edtamarin/Canon-Intervalometer/Hardware/remote_shutter/BOM.xlsx

Part | Description | Price | Qty | Total | Link
ESP32 Pico Mini 02 | MCU | €4.73 | 1 | €4.73 | ESP32-PICO-MINI-02-N8R2 Espressif Systems | C2980306 - LCSC Electronics (https://www.lcsc.com/product-detail/WiFi-Modules_Espressif-Systems-ESP32-PICO-MINI-02-N8R2_C2980306.html)
4-1437565-2 | Pushbuttons | €0.20 | 5 | €1.00 | 4-1437565-2 TE Connectivity | C86487 - LCSC Electronics (https://www.lcsc.com/product-detail/Tactile-Switches_TE-Connectivity-4-1437565-2_C86487.html)
C18594 | 3.5mm jack | €0.55 | 1 | €0.55 | C18594 BOOMELE(Boom Precision Elec) | C18594 - LCSC Electronics (https://www.lcsc.com/product-detail/Audio-Connectors_BOOMELE-Boom-Precision-Elec-C18594_C18594.html)
SIQ-02FVS3 | Rotary encoder | €2.01 | 1 | €2.01 | SIQ-02FVS3 Mitsumi Electric | C2925423 - LCSC Electronics (https://www.lcsc.com/product-detail/Rotary-Encoders_Mitsumi-Electric-SIQ-02FVS3_C2925423.html)
 | OLED Display | €23.50 | 1 | €23.50 | Monochroom 0.96" 128x64 OLED grafisch display (kiwi-electronics.com) (https://www.kiwi-electronics.com/nl/monochroom-0-96quot-128x64-oled-grafisch-display-754?search=oled)
DMN2056U-7 | N-MOSFET | €0.62 | 2 | €1.24 | DMN2056U-7 Diodes Incorporated | C332302 - LCSC Electronics (https://www.lcsc.com/product-detail/MOSFETs_Diodes-Incorporated-DMN2056U-7_C332302.html)
SBC847BDW1T1G | BJT | €0.62 | 1 | €0.62 | SBC847BDW1T1G onsemi | C232475 - LCSC Electronics (https://www.lcsc.com/product-detail/Bipolar-Transistors-BJT_onsemi-SBC847BDW1T1G_C232475.html)
U262-161N-4BVC11 | USB-C connector | €0.39 | 1 | €0.39 | U262-161N-4BVC11 XKB Connectivity | C319148 - LCSC Electronics (https://www.lcsc.com/product-detail/USB-Connectors_XKB-Connectivity-U262-161N-4BVC11_C319148.html)
AZ1117H-3.3TRE1 | LDO | €0.12 | 1 | €0.12 | AZ1117H-3.3TRE1 Diodes Incorporated | C92517 - LCSC Electronics (https://www.lcsc.com/product-detail/Linear-Voltage-Regulators-LDO_Diodes-Incorporated-AZ1117H-3-3TRE1_C92517.html)
NX3215SA-32.768K-STD-MUA-14 | Crystal | €0.37 | 1 | €0.37 | NX3215SA-32.768K-STD-MUA-14 NDK | C156244 - LCSC Electronics (https://www.lcsc.com/product-detail/Crystals_NDK-NX3215SA-32-768K-STD-MUA-14_C156244.html)
TC212B106K020Y | Tantalum capacitor | €0.24 | 1 | €0.24 | TC212B106K020Y Sunlord | C177761 - LCSC Electronics (https://www.lcsc.com/product-detail/Tantalum-Capacitors_Sunlord-TC212B106K020Y_C177761.html)
TAJB226K010RNJ | Tantalum capacitor | €0.07 | 1 | €0.07 | TAJB226K010RNJ Kyocera AVX | C7198 - LCSC Electronics (https://www.lcsc.com/product-detail/Tantalum-Capacitors_Kyocera-AVX-TAJB226K010RNJ_C7198.html)
MK-12D18-G020 | Slide switch | €0.63 | 1 | €0.63 | MK-12D18-G020 G-Switch | C3019727 - LCSC Electronics (https://www.lcsc.com/product-detail/Slide-Switches_G-Switch-MK-12D18-G020_C3019727.html)
 | USB-UART converter |  |  | €0.00 | 1317 POLOLU - Module: adapter | USB-UART; CP2102N; USB micro; 1.5x2.4mm; POLOLU-1317 | TME - Elektronische Componenten (https://www.tme.eu/nl/details/pololu-1317/converters/pololu/1317/)
TP4056 | Charge control circuit | €0.58 | 1 | €0.58 | TP4056 TPOWER | C382139 - LCSC Electronics (https://www.lcsc.com/product-detail/Battery-Management-ICs_TPOWER-TP4056_C382139.html)
