edtamarin/Canon-Intervalometer/Hardware/remote_shutter/remote_shutter.kicad_pcb

## KiCad design Hardware/remote_shutter/remote_shutter.kicad_pcb (2023-05-07)

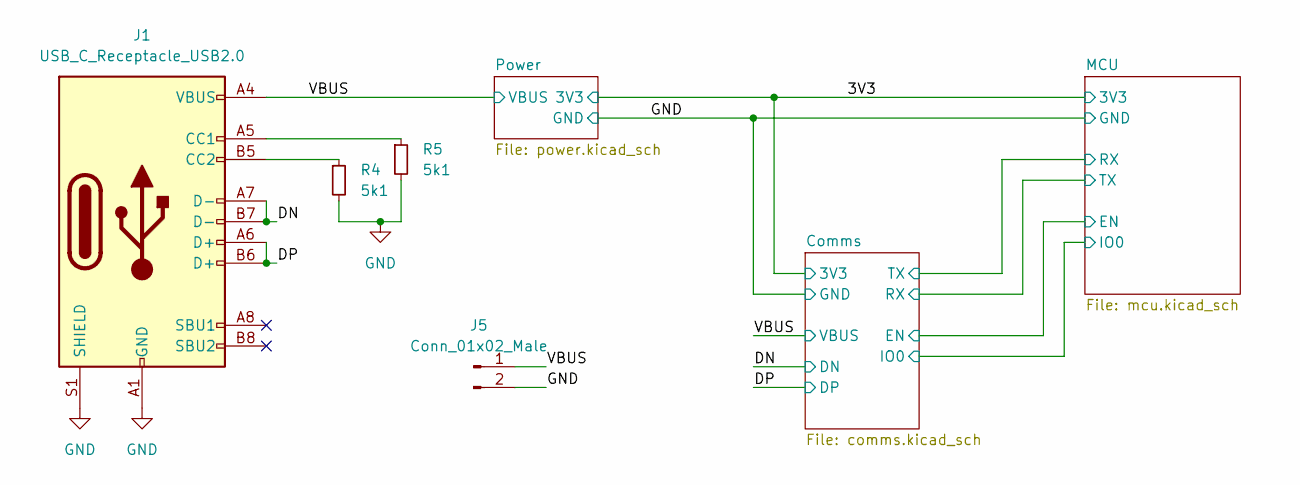
[picture p1: schematic remote_shutter.kicad_sch]

Parts:
J1: USB_C_Receptacle_USB2.0; USB_C_Receptacle_XKB_U262-16XN-4BVC11
J5: Conn_01x02_Male; PinHeader_1x02_P2.54mm_Vertical
R4, R5: 5k1; R_0603_1608Metric_Pad0.98x0.95mm_HandSolder

Connections:
/DN: J1.A7 (D-), J1.B7 (D-); also elsewhere on the board
/DP: J1.A6 (D+), J1.B6 (D+); also elsewhere on the board
/VBUS: J1.A4 (VBUS), J1.A9 (VBUS), J1.B4 (VBUS), J1.B9 (VBUS), J5.1; also elsewhere on the board
GND: J1.A1 (GND), J1.A12 (GND), J1.B1 (GND), J1.B12 (GND), J1.S1 (SHIELD), J5.2, R4.2, R5.2; also elsewhere on the board
unnamed: J1.A5 (CC1), R5.1
unnamed: J1.B5 (CC2), R4.1

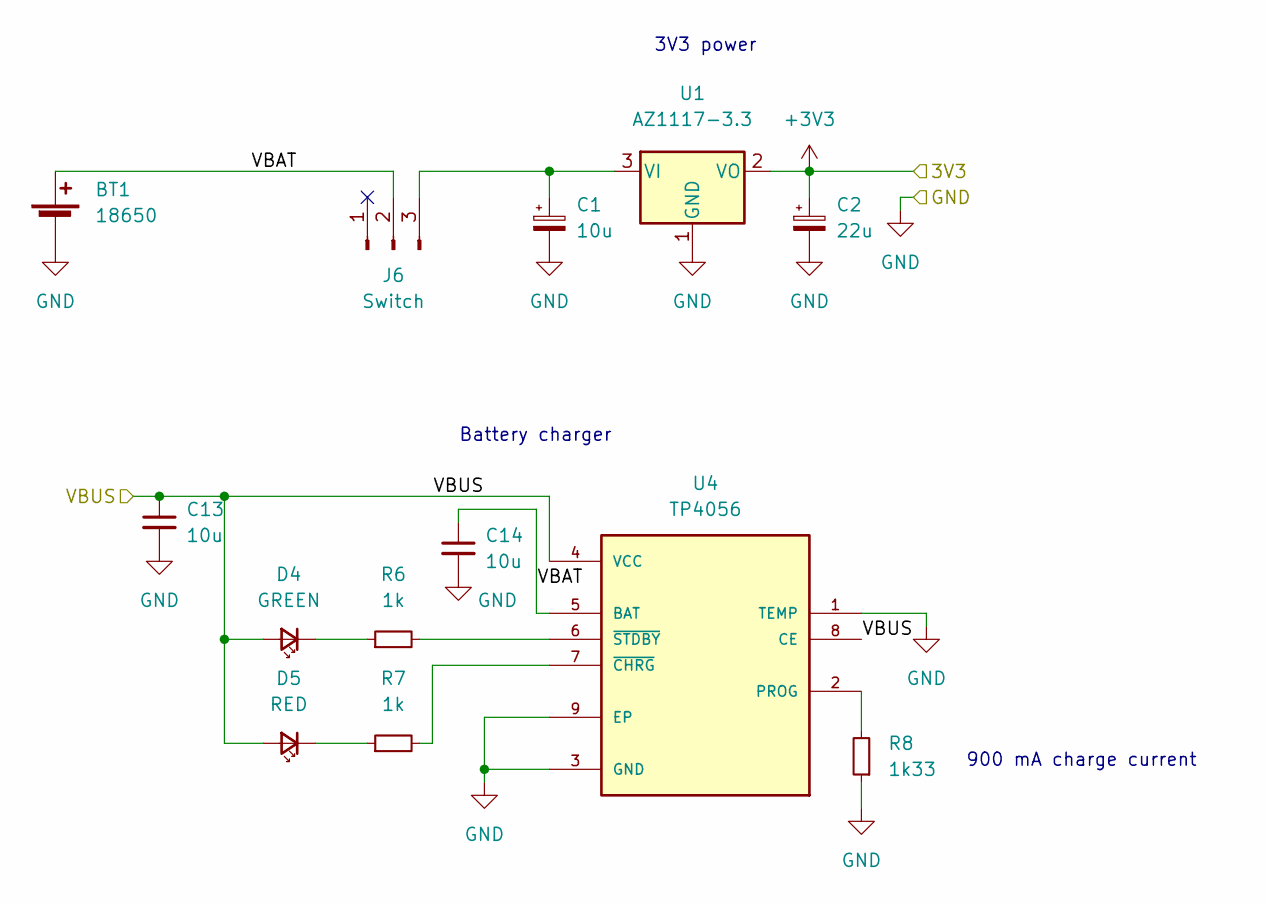
[picture p2: schematic power.kicad_sch]

Parts:
BT1: 18650; PinHeader_1x02_P2.54mm_Vertical
C1: 10u; CP_EIA-3528-21_Kemet-B_Pad1.50x2.35mm_HandSolder
C2: 22u; CP_EIA-3528-21_Kemet-B_Pad1.50x2.35mm_HandSolder
C13, C14: 10u; C_0805_2012Metric_Pad1.18x1.45mm_HandSolder
D4: GREEN; LED_0603_1608Metric_Pad1.05x0.95mm_HandSolder
D5: RED; LED_0603_1608Metric_Pad1.05x0.95mm_HandSolder
J6: Switch; PinHeader_1x03_P2.54mm_Vertical
R6, R7: 1k; R_0603_1608Metric_Pad0.98x0.95mm_HandSolder
R8: 1k33; R_0603_1608Metric_Pad0.98x0.95mm_HandSolder
U1: AZ1117-3.3; SOT-223-3_TabPin2
U4: TP4056; SOP127P600X175-9N

Connections:
+3V3: C2.1, U1.2 (VO); also elsewhere on the board
/Power/VBAT: BT1.1 (+), C14.1, J6.2, U4.5 (BAT)
/VBUS: C13.1, D4.2 (A), D5.2 (A), U4.4 (VCC), U4.8 (CE); also elsewhere on the board
GND: BT1.2 (-), C1.2, C2.2, C13.2, C14.2, R8.1, U1.1 (GND), U4.1 (TEMP), U4.3 (GND), U4.9 (EP); also elsewhere on the board
unnamed: C1.1, J6.3, U1.3 (VI)
unnamed: D4.1 (K), R6.1
unnamed: D5.1 (K), R7.1
unnamed: R6.2, U4.6 (~STDBY)
unnamed: R7.2, U4.7 (~CHRG)
unnamed: R8.2, U4.2 (PROG)

Notes on the sheet:
3V3 power
900 mA charge current
Battery charger

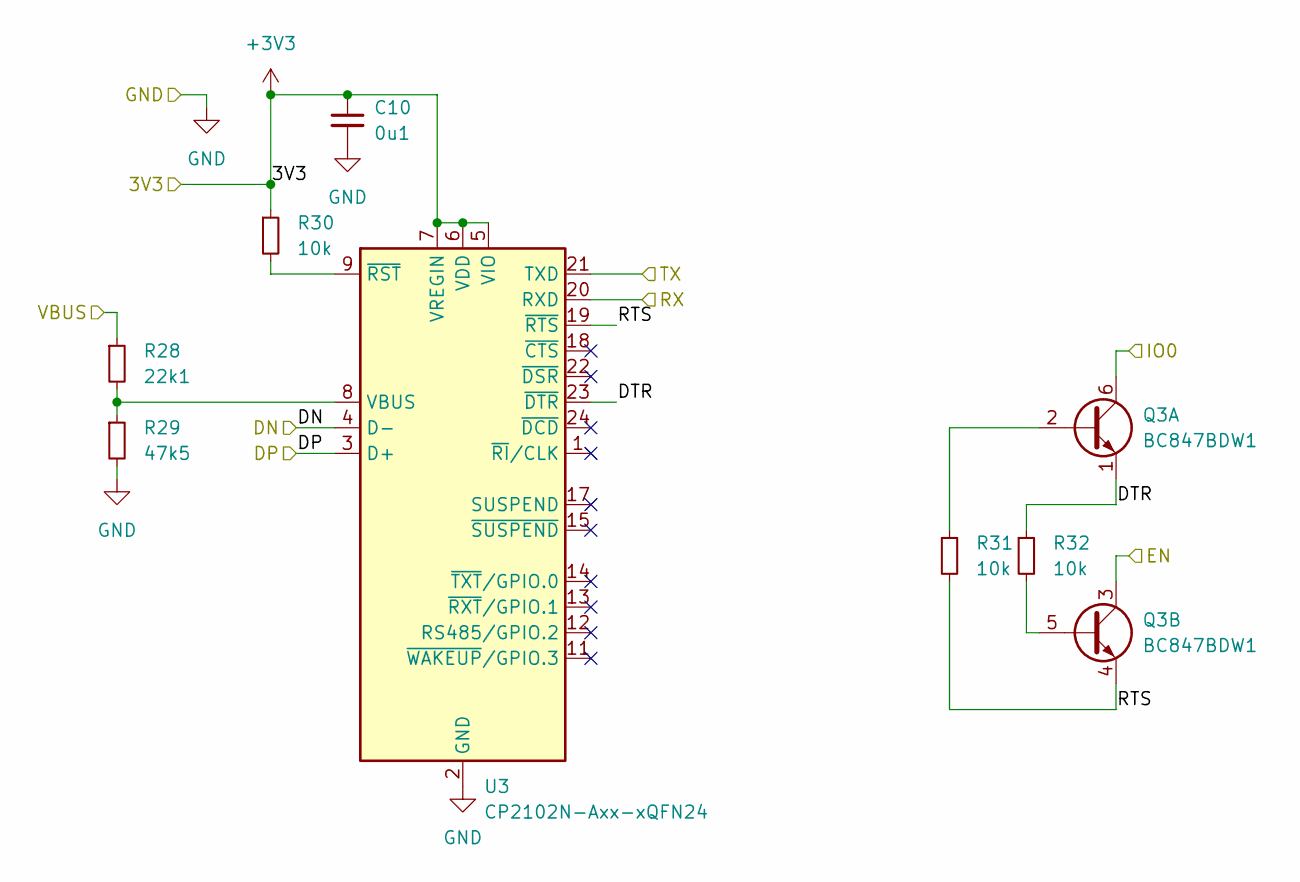
[picture p3: schematic comms.kicad_sch]

Parts:
C10: 0u1; C_0603_1608Metric_Pad1.08x0.95mm_HandSolder
Q3: BC847BDW1; SOT-363_SC-70-6
R28: 22k1; R_0603_1608Metric_Pad0.98x0.95mm_HandSolder
R29: 47k5; R_0603_1608Metric_Pad0.98x0.95mm_HandSolder
R30, R31, R32: 10k; R_0603_1608Metric_Pad0.98x0.95mm_HandSolder
U3: CP2102N-Axx-xQFN24; QFN-24-1EP_4x4mm_P0.5mm_EP2.6x2.6mm

Connections:
+3V3: C10.1, R30.1, U3.5 (VIO), U3.6 (VDD), U3.7 (VREGIN); also elsewhere on the board
/Comms/DTR: Q3.1 (E1), R32.1, U3.23 (~DTR)
/Comms/RTS: Q3.4 (E2), R31.2, U3.19 (~RTS)
/DN: U3.4 (D-); also elsewhere on the board
/DP: U3.3 (D+); also elsewhere on the board
/MCU/EN: Q3.3 (C2); also elsewhere on the board
/MCU/IO0: Q3.6 (C1); also elsewhere on the board
/MCU/RX: U3.21 (TXD); also elsewhere on the board
/MCU/TX: U3.20 (RXD); also elsewhere on the board
/VBUS: R28.1; also elsewhere on the board
GND: C10.2, R29.2, U3.2 (GND), U3.25 (GND); also elsewhere on the board
unnamed: Q3.2 (B1), R31.1
unnamed: Q3.5 (B2), R32.2
unnamed: R28.2, R29.1, U3.8 (VBUS)
unnamed: R30.2, U3.9 (~RST)

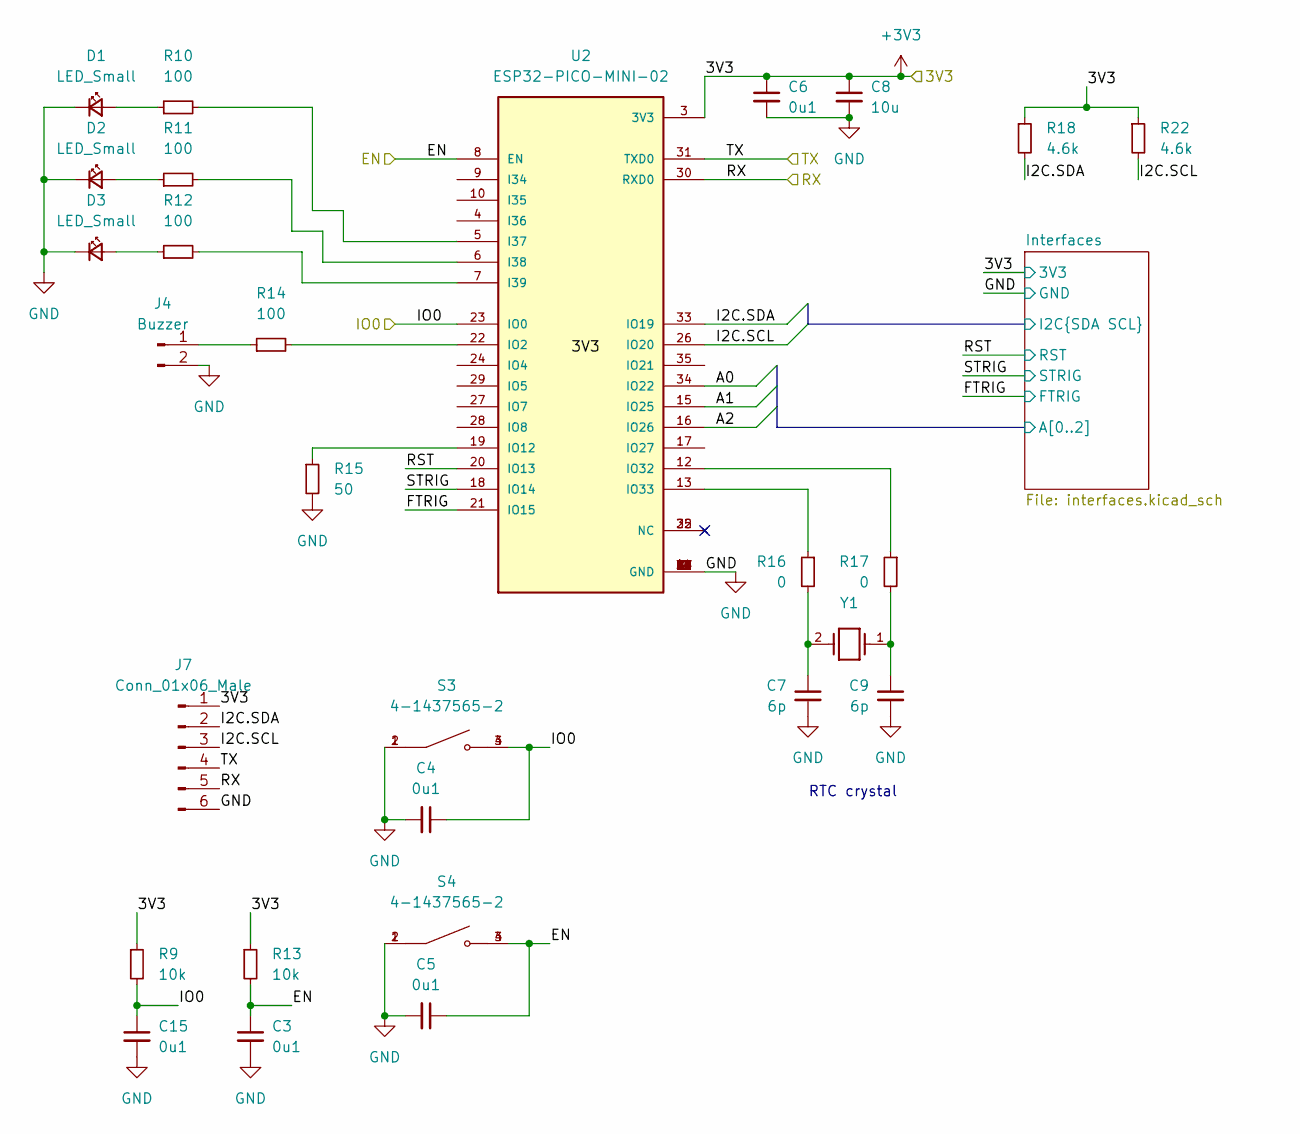
[picture p4: schematic mcu.kicad_sch]

Parts:
C3, C4, C5, C6, C15: 0u1; C_0603_1608Metric_Pad1.08x0.95mm_HandSolder
C7, C9: 6p; C_0603_1608Metric_Pad1.08x0.95mm_HandSolder
C8: 10u; C_0805_2012Metric_Pad1.18x1.45mm_HandSolder
D1, D2, D3: LED_Small; LED_0603_1608Metric_Pad1.05x0.95mm_HandSolder
J4: Buzzer; PinSocket_1x02_P2.54mm_Vertical
J7: Conn_01x06_Male; PinHeader_1x06_P2.54mm_Vertical
R9, R13: 10k; R_0603_1608Metric_Pad0.98x0.95mm_HandSolder
R10, R11, R12, R14: 100; R_0603_1608Metric_Pad0.98x0.95mm_HandSolder
R15: 50; R_0603_1608Metric_Pad0.98x0.95mm_HandSolder
R16, R17: 0; R_0603_1608Metric_Pad0.98x0.95mm_HandSolder
R18, R22: 4.6k; R_0603_1608Metric_Pad0.98x0.95mm_HandSolder
S3, S4: 4-1437565-2; SW_4-1437565-2
U2: ESP32-PICO-MINI-02; MODULE_ESP32-PICO-MINI-02; PARTREV v1.0
Y1: NX3215SA-32.768K-STD-MUA-14; XTAL_NX3215SA-32.768K-STD-MUA-14; PARTREV --

Connections:
+3V3: C6.1, C8.1, J7.1, R9.1, R13.1, R18.1, R22.1, U2.3 (3V3); also elsewhere on the board
/MCU/EN: C3.1, C5.1, R13.2, S4.3, S4.4, U2.8 (EN); also elsewhere on the board
/MCU/FTRIG: U2.21 (IO15); also elsewhere on the board
/MCU/IO0: C4.1, C15.1, R9.2, S3.3, S3.4, U2.23 (IO0); also elsewhere on the board
/MCU/Interfaces/A0: U2.34 (IO22); also elsewhere on the board
/MCU/Interfaces/A1: U2.15 (IO25); also elsewhere on the board
/MCU/Interfaces/A2: U2.16 (IO26); also elsewhere on the board
/MCU/Interfaces/I2C.SCL: J7.3, R22.2, U2.26 (IO20); also elsewhere on the board
/MCU/Interfaces/I2C.SDA: J7.2, R18.2, U2.33 (IO19); also elsewhere on the board
/MCU/RST: U2.20 (IO13); also elsewhere on the board
/MCU/RX: J7.5, U2.30 (RXD0); also elsewhere on the board
/MCU/STRIG: U2.18 (IO14); also elsewhere on the board
/MCU/TX: J7.4, U2.31 (TXD0); also elsewhere on the board
GND: C3.2, C4.2, C5.2, C6.2, C7.2, C8.2, C9.2, C15.2, D1.1 (K), D2.1 (K), D3.1 (K), J4.2, J7.6, R15.2, S3.1, S3.2, S4.1, S4.2, U2.1 (GND), U2.2 (GND), U2.11 (GND), U2.14 (GND), U2.36 (GND), U2.37 (GND), U2.38 (GND), U2.39 (GND), U2.40 (GND), U2.41 (GND), U2.42 (GND), U2.43 (GND), U2.44 (GND), U2.45 (GND), U2.46 (GND), U2.47 (GND), U2.48 (GND), U2.49 (GND), U2.50 (GND), U2.51 (GND), U2.52 (GND), U2.53 (GND), U2.54 (GND), U2.55 (GND), U2.56 (GND), U2.57 (GND), U2.58 (GND), U2.59 (GND), U2.60 (GND), U2.61 (GND); also elsewhere on the board
unnamed: C7.1, R16.2, Y1.2
unnamed: C9.1, R17.2, Y1.1
unnamed: D1.2 (A), R10.1
unnamed: D2.2 (A), R11.1
unnamed: D3.2 (A), R12.1
unnamed: J4.1, R14.1
unnamed: R10.2, U2.5 (I37)
unnamed: R11.2, U2.6 (I38)
unnamed: R12.2, U2.7 (I39)
unnamed: R14.2, U2.22 (IO2)
unnamed: R15.1, U2.19 (IO12)
unnamed: R16.1, U2.13 (IO33)
unnamed: R17.1, U2.12 (IO32)

Notes on the sheet:
RTC crystal

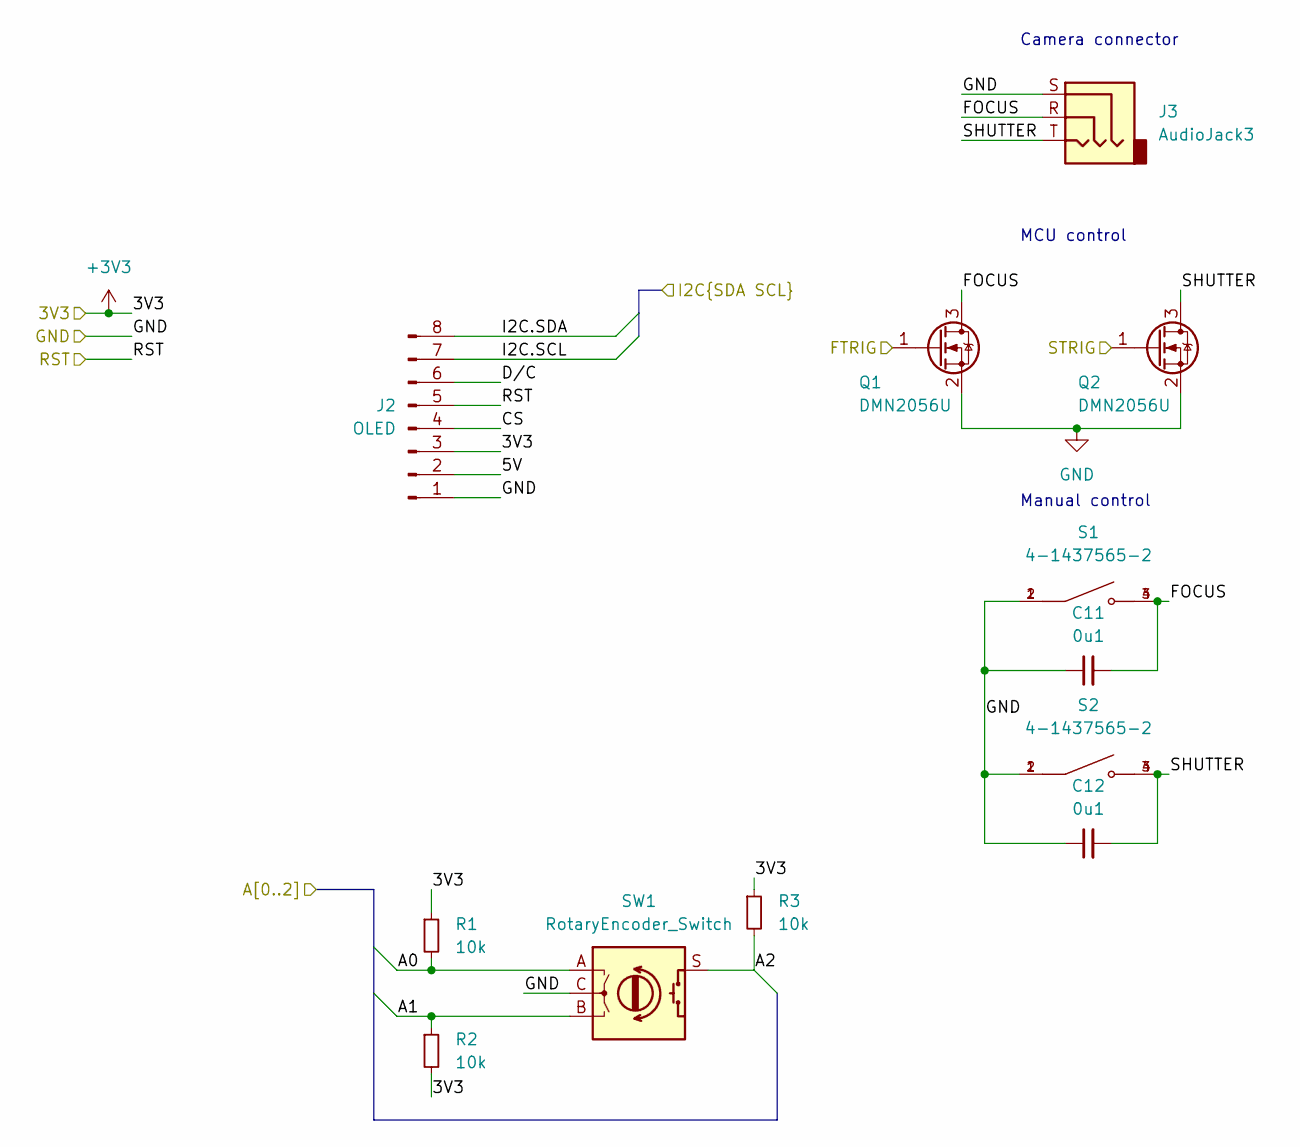
[picture p5: schematic interfaces.kicad_sch]

Parts:
C11, C12: 0u1; C_0603_1608Metric_Pad1.08x0.95mm_HandSolder
J2: OLED; PinSocket_1x08_P2.54mm_Vertical
J3: AudioJack3; PJ-320B
Q1, Q2: DMN2056U; SOT-23
R1, R2, R3: 10k; R_0603_1608Metric_Pad0.98x0.95mm_HandSolder
S1, S2: 4-1437565-2; SW_4-1437565-2
SW1: RotaryEncoder_Switch; SIQ-02FVS3

Connections:
+3V3: J2.3, R1.1, R2.2, R3.1; also elsewhere on the board
/MCU/FTRIG: Q1.1 (G); also elsewhere on the board
/MCU/Interfaces/5V: J2.2
/MCU/Interfaces/A0: R1.2, SW1.A; also elsewhere on the board
/MCU/Interfaces/A1: R2.1, SW1.B; also elsewhere on the board
/MCU/Interfaces/A2: R3.2, SW1.S; also elsewhere on the board
/MCU/Interfaces/CS: J2.4
/MCU/Interfaces/D/C: J2.6
/MCU/Interfaces/FOCUS: C11.2, J3.R, Q1.3 (D), S1.3, S1.4
/MCU/Interfaces/I2C.SCL: J2.7; also elsewhere on the board
/MCU/Interfaces/I2C.SDA: J2.8; also elsewhere on the board
/MCU/Interfaces/SHUTTER: C12.2, J3.T, Q2.3 (D), S2.3, S2.4
/MCU/RST: J2.5; also elsewhere on the board
/MCU/STRIG: Q2.1 (G); also elsewhere on the board
GND: C11.1, C12.1, J2.1, J3.S, Q1.2 (S), Q2.2 (S), S1.1, S1.2, S2.1, S2.2, SW1.C; also elsewhere on the board

Notes on the sheet:
MCU control
Manual control
Camera connector

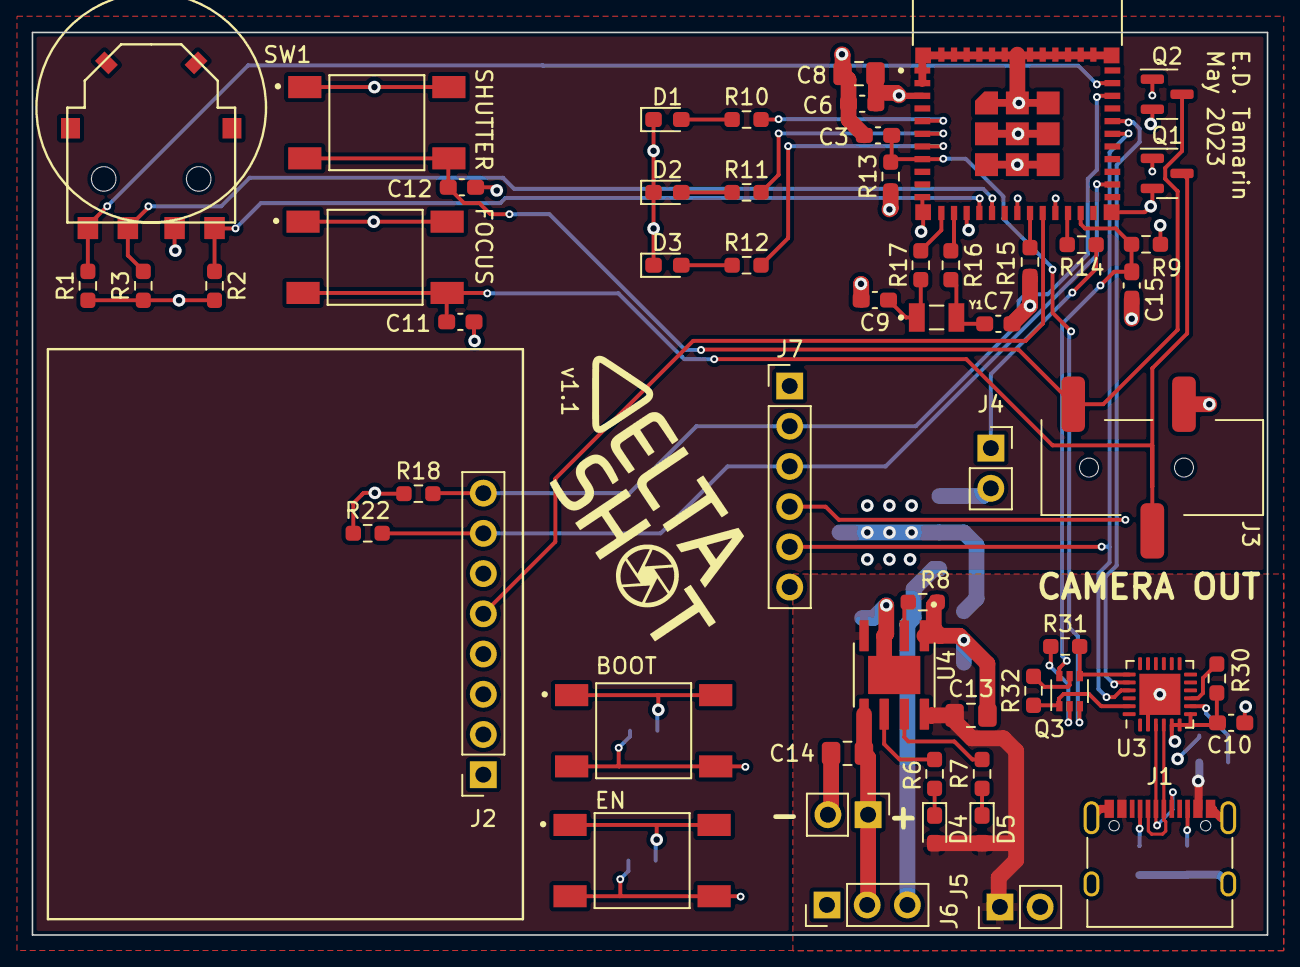
[picture p6: board remote_shutter.kicad_pcb from above]

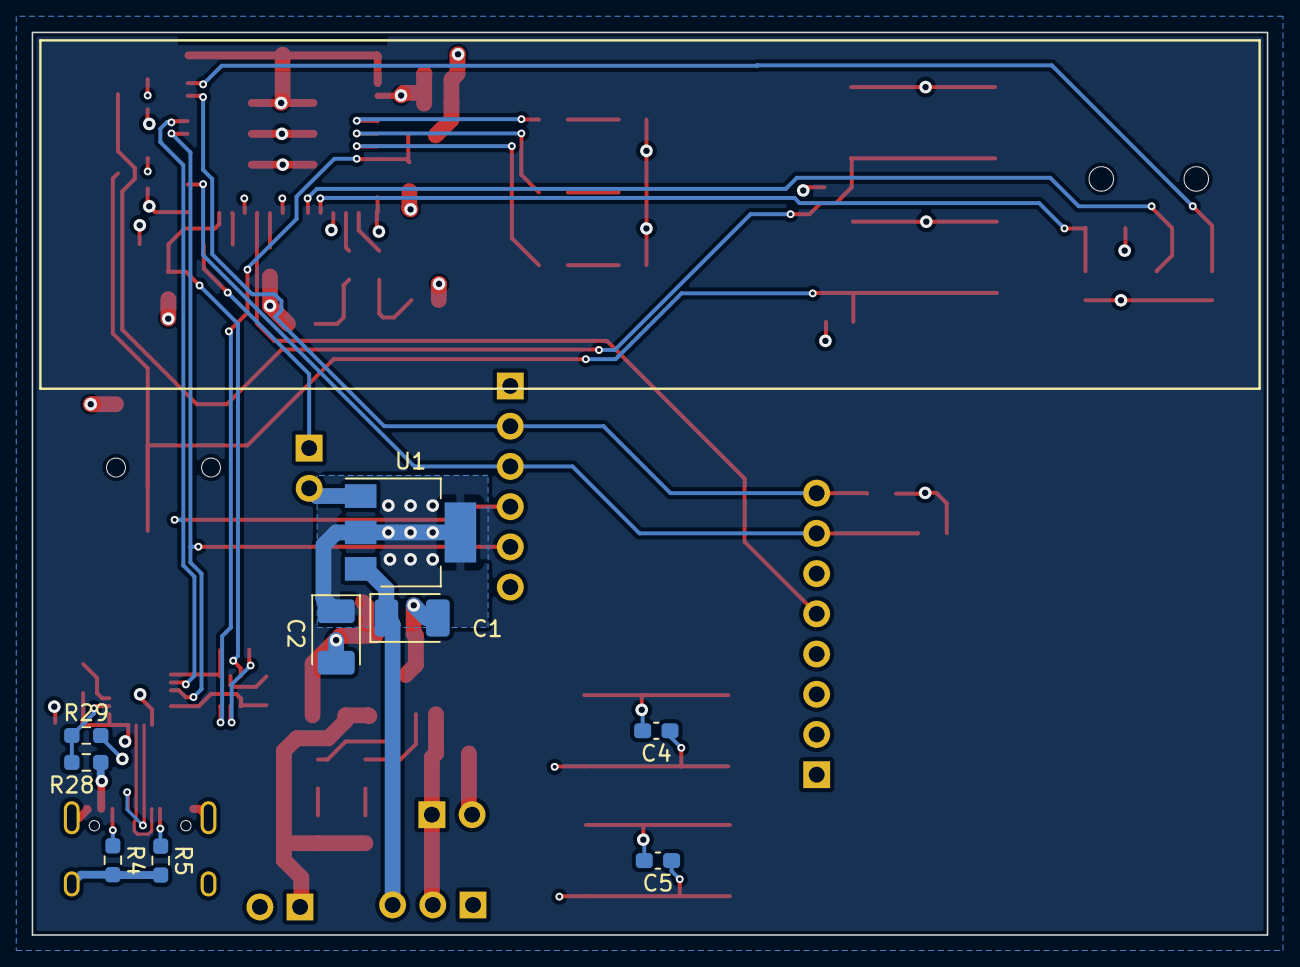
[picture p7: board remote_shutter.kicad_pcb from below]

Board: 4 copper layers, 78.0 x 57.0 mm, 65 parts (9 on the bottom side), 47 nets.
