edtamarin/Canon-Intervalometer/Hardware/remote_shutter_controller/remote_shutter_controller.kicad_pcb

## KiCad design Hardware/remote_shutter_controller/remote_shutter_controller.kicad_pcb (2023-01-23)

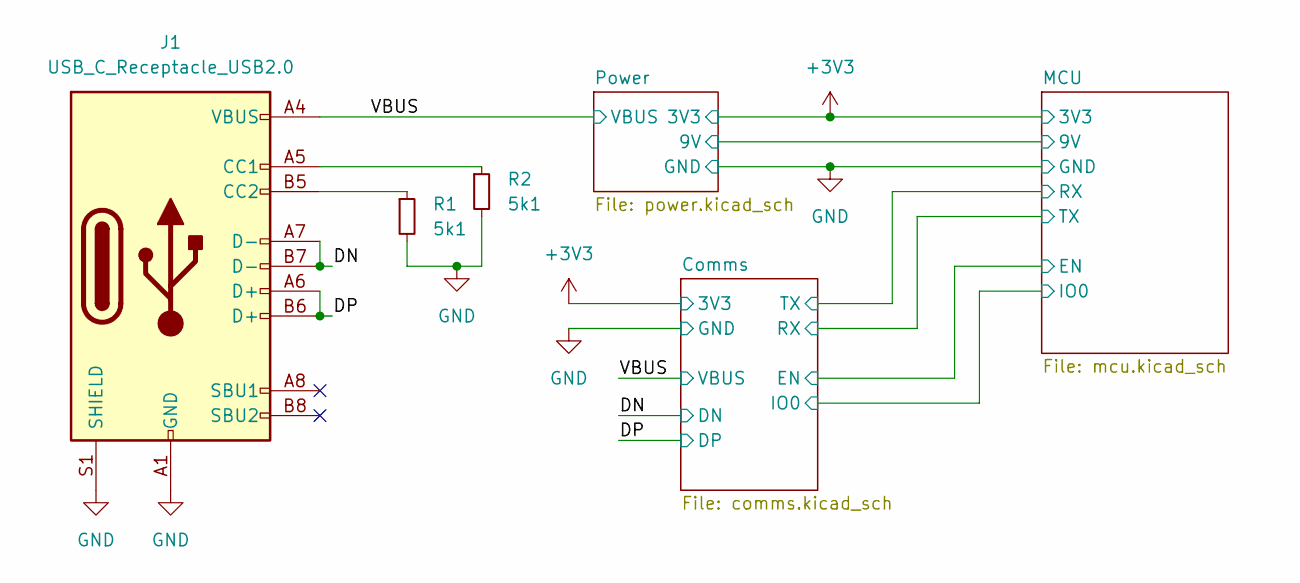
[picture p8: schematic remote_shutter_controller.kicad_sch]

Parts:
J1: USB_C_Receptacle_USB2.0; USB_C_Receptacle_XKB_U262-16XN-4BVC11
R1, R2: 5k1; R_0603_1608Metric_Pad0.98x0.95mm_HandSolder

Connections:
/DN: J1.A7 (D-), J1.B7 (D-); also elsewhere on the board
/DP: J1.A6 (D+), J1.B6 (D+); also elsewhere on the board
/VBUS: J1.A4 (VBUS), J1.A9 (VBUS), J1.B4 (VBUS), J1.B9 (VBUS); also elsewhere on the board
GND: J1.A1 (GND), J1.A12 (GND), J1.B1 (GND), J1.B12 (GND), J1.S1 (SHIELD), R1.2, R2.2; also elsewhere on the board
unnamed: J1.A5 (CC1), R2.1
unnamed: J1.B5 (CC2), R1.1

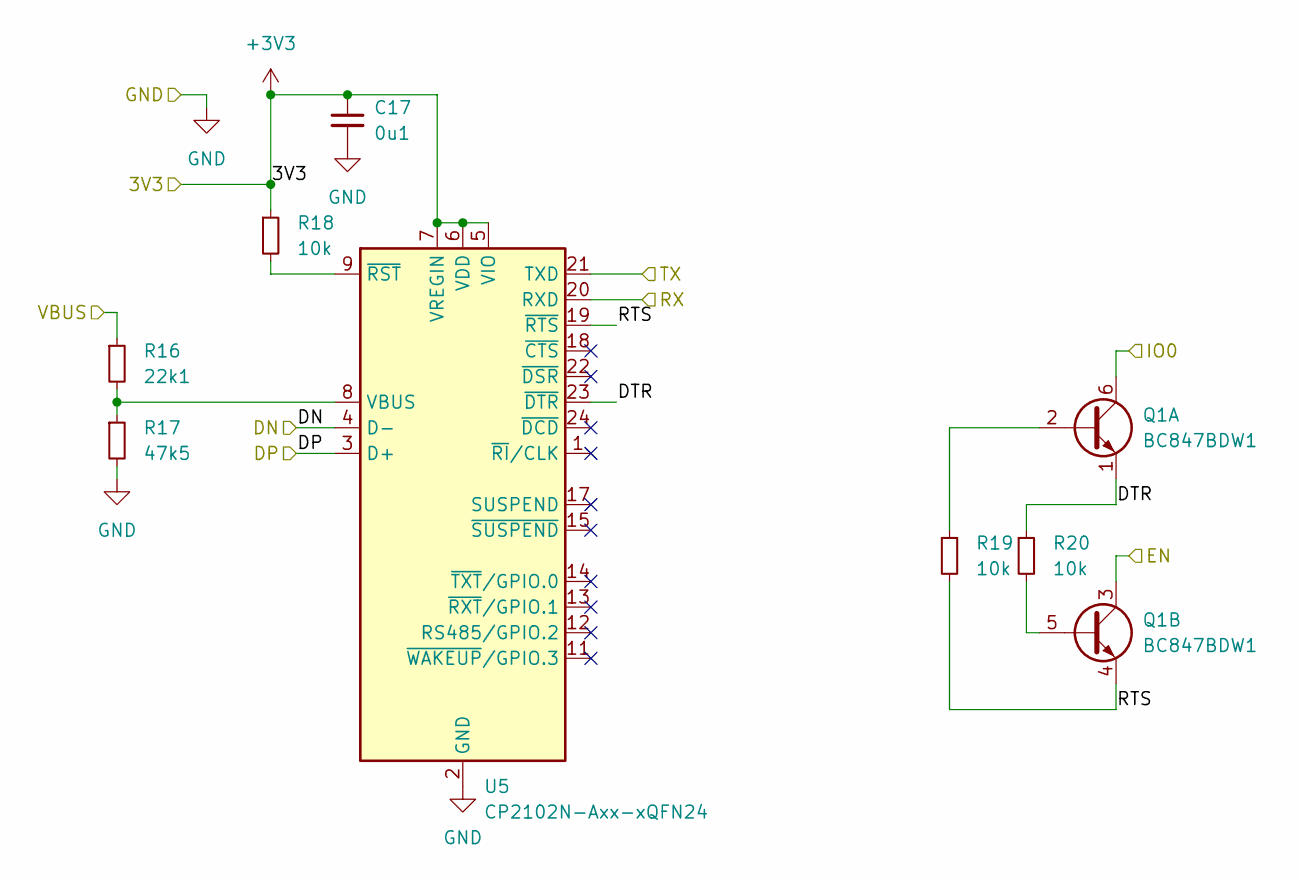
[picture p9: schematic comms.kicad_sch]

Parts:
C17: 0u1; C_0603_1608Metric_Pad1.08x0.95mm_HandSolder
Q1: BC847BDW1; SOT-363_SC-70-6
R16: 22k1; R_0603_1608Metric_Pad0.98x0.95mm_HandSolder
R17: 47k5; R_0603_1608Metric_Pad0.98x0.95mm_HandSolder
R18, R19, R20: 10k; R_0603_1608Metric_Pad0.98x0.95mm_HandSolder
U5: CP2102N-Axx-xQFN24; QFN-24-1EP_4x4mm_P0.5mm_EP2.6x2.6mm

Connections:
+3V3: C17.1, R18.1, U5.5 (VIO), U5.6 (VDD), U5.7 (VREGIN); also elsewhere on the board
/Comms/DTR: Q1.1 (E1), R20.1, U5.23 (~DTR)
/Comms/RTS: Q1.4 (E2), R19.2, U5.19 (~RTS)
/Comms/RX: U5.20 (RXD); also elsewhere on the board
/Comms/TX: U5.21 (TXD); also elsewhere on the board
/DN: U5.4 (D-); also elsewhere on the board
/DP: U5.3 (D+); also elsewhere on the board
/MCU/EN: Q1.3 (C2); also elsewhere on the board
/MCU/IO0: Q1.6 (C1); also elsewhere on the board
/VBUS: R16.1; also elsewhere on the board
GND: C17.2, R17.2, U5.2 (GND), U5.25 (GND); also elsewhere on the board
unnamed: Q1.2 (B1), R19.1
unnamed: Q1.5 (B2), R20.2
unnamed: R16.2, R17.1, U5.8 (VBUS)
unnamed: R18.2, U5.9 (~RST)

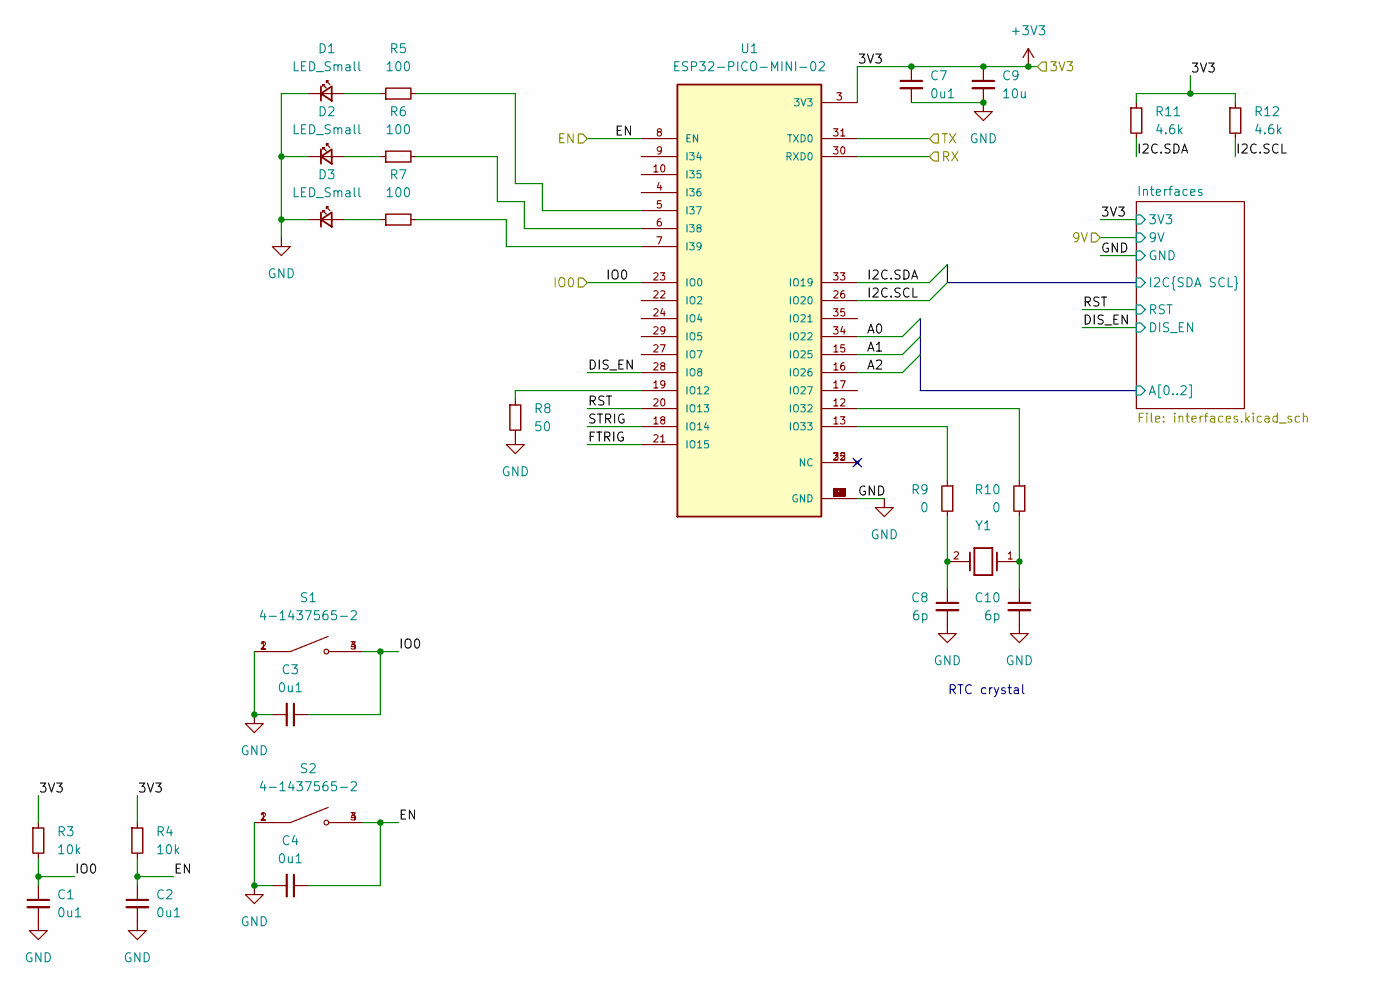
[picture p10: schematic mcu.kicad_sch]

Parts:
C1, C2, C3, C4, C7: 0u1; C_0603_1608Metric_Pad1.08x0.95mm_HandSolder
C8, C10: 6p; C_0603_1608Metric_Pad1.08x0.95mm_HandSolder
C9: 10u; C_0805_2012Metric_Pad1.18x1.45mm_HandSolder
D1, D2, D3: LED_Small; LED_0603_1608Metric_Pad1.05x0.95mm_HandSolder
R3, R4: 10k; R_0603_1608Metric_Pad0.98x0.95mm_HandSolder
R5, R6, R7: 100; R_0603_1608Metric_Pad0.98x0.95mm_HandSolder
R8: 50; R_0603_1608Metric_Pad0.98x0.95mm_HandSolder
R9, R10: 0; R_0603_1608Metric_Pad0.98x0.95mm_HandSolder
R11, R12: 4.6k; R_0603_1608Metric_Pad0.98x0.95mm_HandSolder
S1, S2: 4-1437565-2; SW_4-1437565-2
U1: ESP32-PICO-MINI-02; MODULE_ESP32-PICO-MINI-02; PARTREV v1.0
Y1: NX3215SA-32.768K-STD-MUA-14; XTAL_NX3215SA-32.768K-STD-MUA-14; PARTREV --

Connections:
+3V3: C7.1, C9.1, R3.1, R4.1, R11.1, R12.1, U1.3 (3V3); also elsewhere on the board
/Comms/RX: U1.31 (TXD0); also elsewhere on the board
/Comms/TX: U1.30 (RXD0); also elsewhere on the board
/MCU/DIS_EN: U1.28 (IO8); also elsewhere on the board
/MCU/EN: C2.1, C4.1, R4.2, S2.3, S2.4, U1.8 (EN); also elsewhere on the board
/MCU/FTRIG: U1.21 (IO15)
/MCU/IO0: C1.1, C3.1, R3.2, S1.3, S1.4, U1.23 (IO0); also elsewhere on the board
/MCU/Interfaces/A0: U1.34 (IO22); also elsewhere on the board
/MCU/Interfaces/A1: U1.15 (IO25); also elsewhere on the board
/MCU/Interfaces/A2: U1.16 (IO26); also elsewhere on the board
/MCU/Interfaces/I2C.SCL: R12.2, U1.26 (IO20); also elsewhere on the board
/MCU/Interfaces/I2C.SDA: R11.2, U1.33 (IO19); also elsewhere on the board
/MCU/RST: U1.20 (IO13); also elsewhere on the board
/MCU/STRIG: U1.18 (IO14)
GND: C1.2, C2.2, C3.2, C4.2, C7.2, C8.2, C9.2, C10.2, D1.1 (K), D2.1 (K), D3.1 (K), R8.2, S1.1, S1.2, S2.1, S2.2, U1.1 (GND), U1.2 (GND), U1.11 (GND), U1.14 (GND), U1.36 (GND), U1.37 (GND), U1.38 (GND), U1.39 (GND), U1.40 (GND), U1.41 (GND), U1.42 (GND), U1.43 (GND), U1.44 (GND), U1.45 (GND), U1.46 (GND), U1.47 (GND), U1.48 (GND), U1.49 (GND), U1.50 (GND), U1.51 (GND), U1.52 (GND), U1.53 (GND), U1.54 (GND), U1.55 (GND), U1.56 (GND), U1.57 (GND), U1.58 (GND), U1.59 (GND), U1.60 (GND), U1.61 (GND); also elsewhere on the board
unnamed: C8.1, R9.2, Y1.2
unnamed: C10.1, R10.2, Y1.1
unnamed: D1.2 (A), R5.1
unnamed: D2.2 (A), R6.1
unnamed: D3.2 (A), R7.1
unnamed: R5.2, U1.5 (I37)
unnamed: R6.2, U1.6 (I38)
unnamed: R7.2, U1.7 (I39)
unnamed: R8.1, U1.19 (IO12)
unnamed: R9.1, U1.13 (IO33)
unnamed: R10.1, U1.12 (IO32)

Notes on the sheet:
RTC crystal

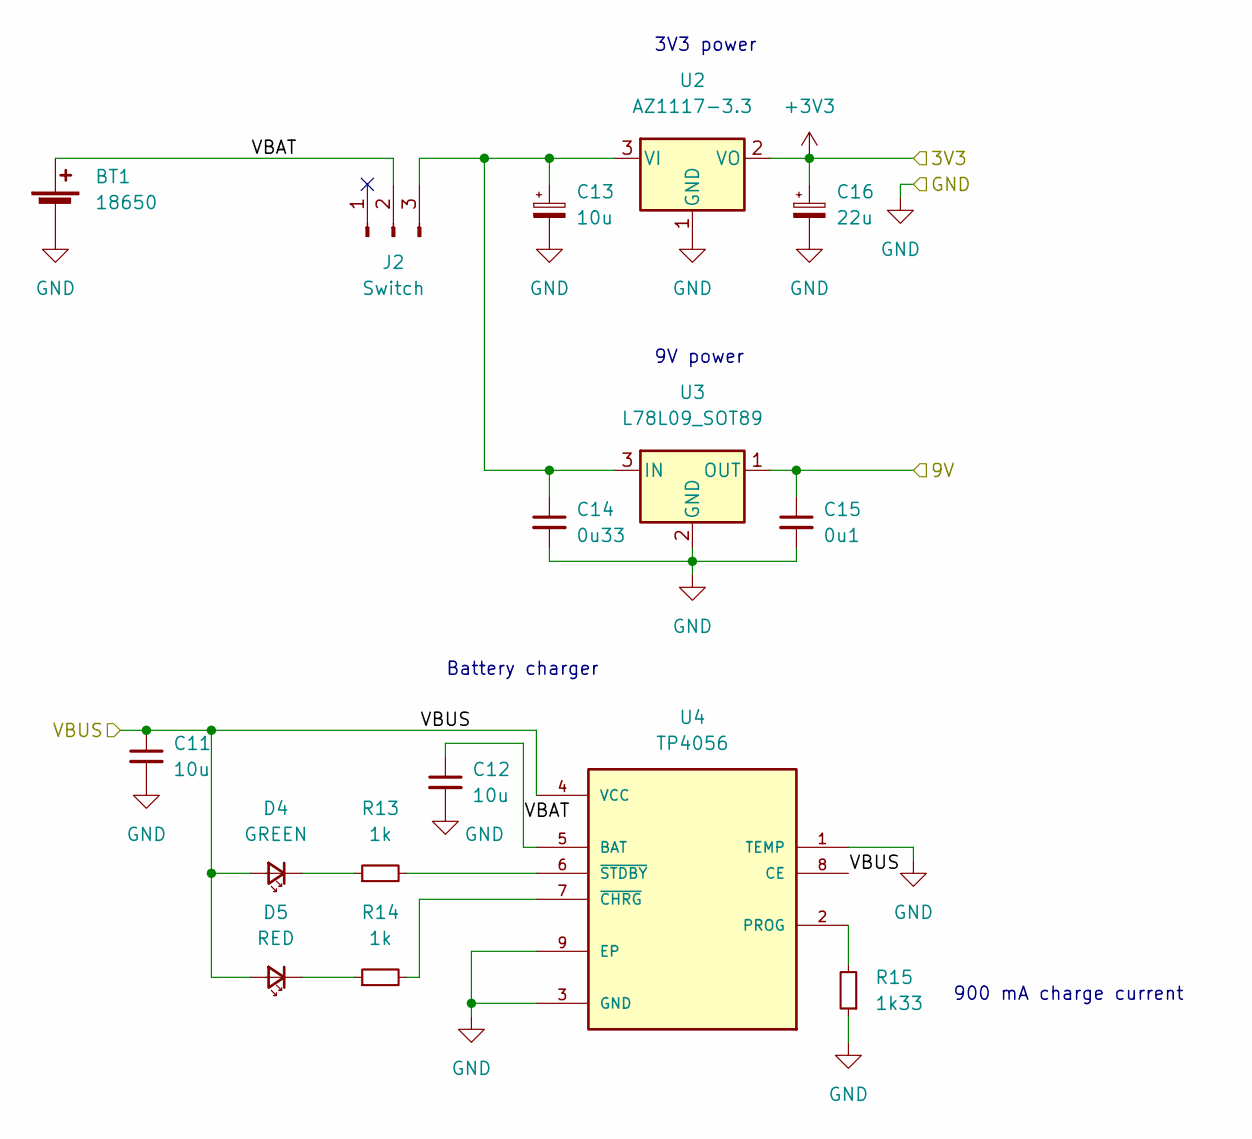
[picture p11: schematic power.kicad_sch]

Parts:
BT1: 18650; JST_PH_S2B-PH-K_1x02_P2.00mm_Horizontal
C11, C12: 10u; C_0805_2012Metric_Pad1.18x1.45mm_HandSolder
C13: 10u; CP_EIA-3528-21_Kemet-B_Pad1.50x2.35mm_HandSolder
C14: 0u33; C_0805_2012Metric_Pad1.18x1.45mm_HandSolder
C15: 0u1; C_0805_2012Metric_Pad1.18x1.45mm_HandSolder
C16: 22u; CP_EIA-3528-21_Kemet-B_Pad1.50x2.35mm_HandSolder
D4: GREEN; LED_0603_1608Metric_Pad1.05x0.95mm_HandSolder
D5: RED; LED_0603_1608Metric_Pad1.05x0.95mm_HandSolder
J2: Switch; PinHeader_1x03_P2.54mm_Vertical
R13, R14: 1k; R_0603_1608Metric_Pad0.98x0.95mm_HandSolder
R15: 1k33; R_0603_1608Metric_Pad0.98x0.95mm_HandSolder
U2: AZ1117-3.3; SOT-223-3_TabPin2
U3: L78L09_SOT89; SOT-89-3
U4: TP4056; SOP127P600X175-9N

Connections:
+3V3: C16.1, U2.2 (VO); also elsewhere on the board
/MCU/9V: C15.1, U3.1 (OUT); also elsewhere on the board
/Power/VBAT: BT1.1 (+), C12.1, J2.2, U4.5 (BAT)
/VBUS: C11.1, D4.2 (A), D5.2 (A), U4.4 (VCC), U4.8 (CE); also elsewhere on the board
GND: BT1.2 (-), C11.2, C12.2, C13.2, C14.2, C15.2, C16.2, R15.1, U2.1 (GND), U3.2 (GND), U4.1 (TEMP), U4.3 (GND), U4.9 (EP); also elsewhere on the board
unnamed: C13.1, C14.1, J2.3, U2.3 (VI), U3.3 (IN)
unnamed: D4.1 (K), R13.1
unnamed: D5.1 (K), R14.1
unnamed: R13.2, U4.6 (~STDBY)
unnamed: R14.2, U4.7 (~CHRG)
unnamed: R15.2, U4.2 (PROG)

Notes on the sheet:
Battery charger
9V power
3V3 power
900 mA charge current

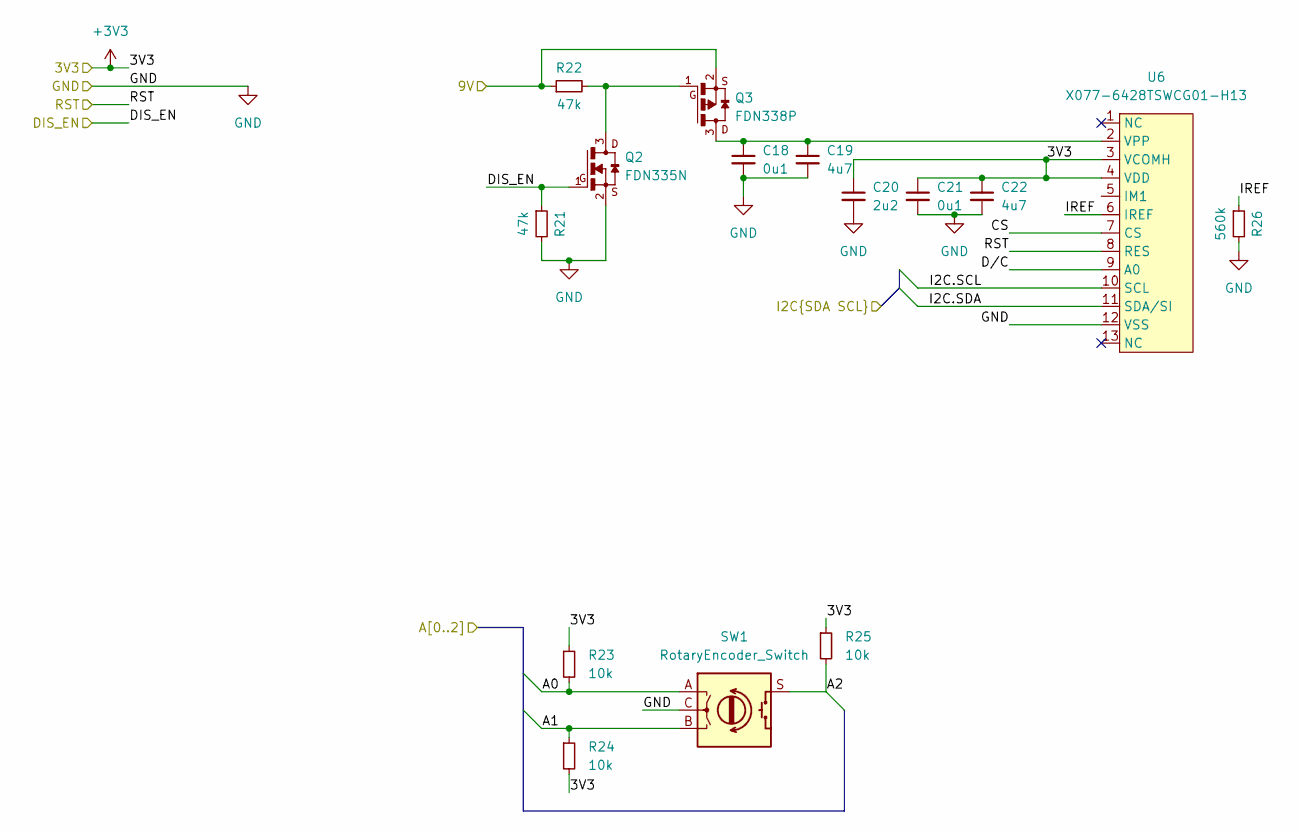
[picture p12: schematic interfaces.kicad_sch]

Parts:
C18, C21: 0u1; C_0603_1608Metric_Pad1.08x0.95mm_HandSolder
C19, C22: 4u7; C_0603_1608Metric_Pad1.08x0.95mm_HandSolder
C20: 2u2; C_0603_1608Metric_Pad1.08x0.95mm_HandSolder
Q2: FDN335N; SSOT-3
Q3: FDN338P; SSOT-3
R21, R22: 47k; R_0603_1608Metric_Pad0.98x0.95mm_HandSolder
R23, R24, R25: 10k; R_0603_1608Metric_Pad0.98x0.95mm_HandSolder
R26: 560k; R_0603_1608Metric_Pad0.98x0.95mm_HandSolder
SW1: RotaryEncoder_Switch; SIQ-02FVS3
U6: X077-6428TSWCG01-H13

Connections:
+3V3: C20.1, C21.1, C22.1, R23.1, R24.2, R25.1, U6.3 (VCOMH), U6.4 (VDD); also elsewhere on the board
/MCU/9V: Q3.2, R22.1; also elsewhere on the board
/MCU/DIS_EN: Q2.1, R21.1; also elsewhere on the board
/MCU/Interfaces/A0: R23.2, SW1.A; also elsewhere on the board
/MCU/Interfaces/A1: R24.1, SW1.B; also elsewhere on the board
/MCU/Interfaces/A2: R25.2, SW1.S; also elsewhere on the board
/MCU/Interfaces/CS: U6.7 (CS)
/MCU/Interfaces/D/C: U6.9 (A0)
/MCU/Interfaces/I2C.SCL: U6.10 (SCL); also elsewhere on the board
/MCU/Interfaces/I2C.SDA: U6.11 (SDA/SI); also elsewhere on the board
/MCU/Interfaces/IREF: R26.1, U6.6 (IREF)
/MCU/RST: U6.8 (RES); also elsewhere on the board
GND: C18.2, C19.2, C20.2, C21.2, C22.2, Q2.2, R21.2, R26.2, SW1.C, U6.12 (VSS); also elsewhere on the board
unnamed: C18.1, C19.1, Q3.3, U6.2 (VPP)
unnamed: Q2.3, Q3.1, R22.2
