edtamarin/Canon-Intervalometer/Hardware/remote_shutter_controller/remote_shutter_controller.kicad_pcb

## KiCad design Hardware/remote_shutter_controller/remote_shutter_controller.kicad_pcb (continued)

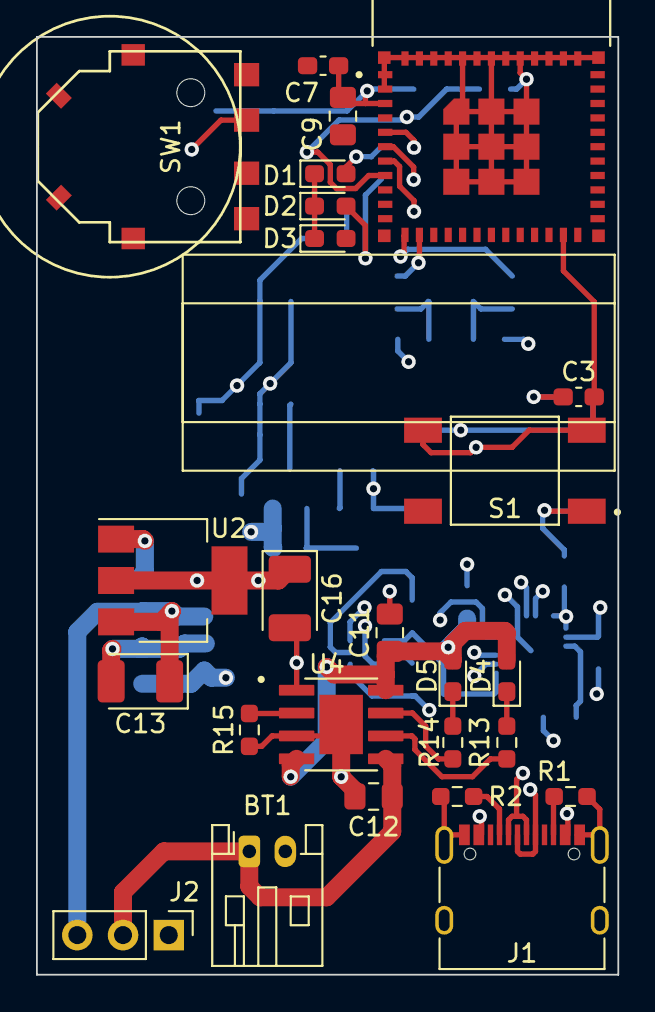
[picture p13: board remote_shutter_controller.kicad_pcb from above]

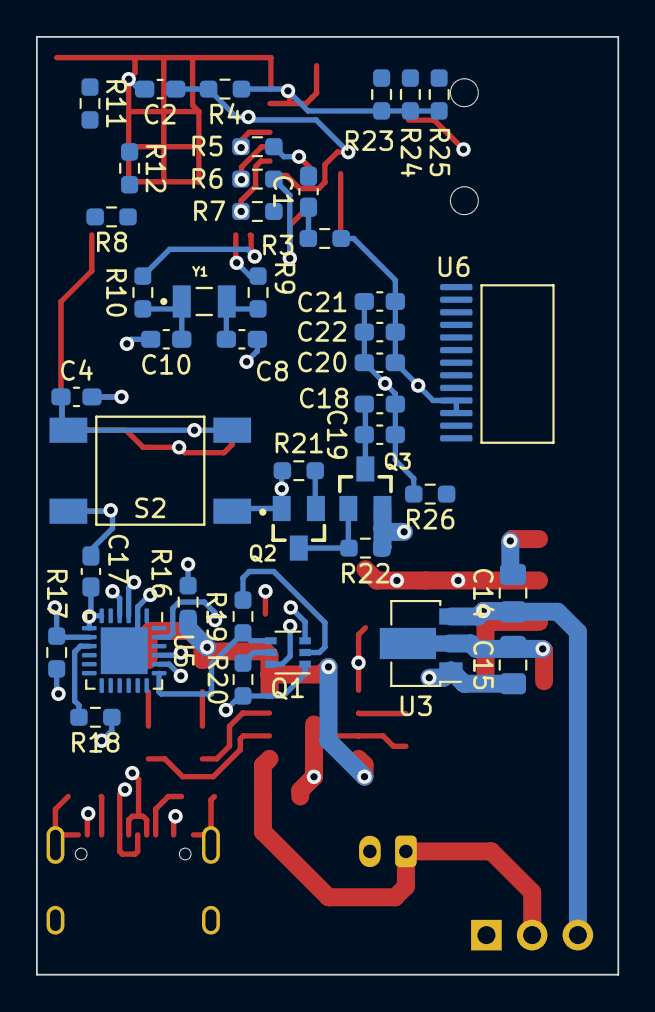
[picture p14: board remote_shutter_controller.kicad_pcb from below]

Board: 4 copper layers, 32.3 x 52.1 mm, 67 parts (42 on the bottom side), 46 nets.
