edtamarin/Canon-Intervalometer/(commit log)

2022-11-23 Initial KiCad project
    [remote_shutter.kicad_pcb, remote_shutter.kicad_sch]
2022-11-23 Initial schematic planning
    Added ESP32, CP2102 and hierarchical sheets.
    [comms.kicad_sch, controls.kicad_sch, mcu.kicad_sch, power.kicad_sch, remote_shutter.kicad_sch]
2022-11-26 Added BOM. Added controls.
    Placed jack, switches, OLED display and rotary encoders.
    [BOM.xlsx, interfaces.kicad_sch, mcu.kicad_sch, remote_shutter.kicad_sch]
2022-11-26 Added power & comms.
    [BOM.xlsx, comms.kicad_sch, interfaces.kicad_sch, mcu.kicad_sch, power.kicad_sch, remote_shutter.kicad_sch]
2022-11-26 Added crystal
    [BOM.xlsx, mcu.kicad_sch, remote_shutter.kicad_sch]
2022-11-26 Added missing footprints. First PCB export.
    [BOM.xlsx, comms.kicad_sch, interfaces.kicad_sch, mcu.kicad_sch, power.kicad_sch, remote_shutter.kicad_pcb, remote_shutter.kicad_sch]
2022-11-26 Fixed bus routing
    [interfaces.kicad_sch, mcu.kicad_sch, remote_shutter.kicad_pcb, remote_shutter.kicad_sch]
2022-11-26 Replaced rotary encoders
    Now one flat to save space.
    [BOM.xlsx, interfaces.kicad_sch, mcu.kicad_sch, remote_shutter.kicad_sch]
2022-11-26 Started routing. Added power switch.
    [BOM.xlsx, comms.kicad_sch, interfaces.kicad_sch, mcu.kicad_sch, power.kicad_sch, remote_shutter.kicad_pcb, remote_shutter.kicad_sch]
2022-11-27 Added LiIon charge circuit
    [comms.kicad_sch, interfaces.kicad_sch, mcu.kicad_sch, power.kicad_sch, remote_shutter.kicad_sch]
2022-11-27 Routing USB and charger.
    [BOM.xlsx, remote_shutter.kicad_pcb, remote_shutter.kicad_sch]
2022-11-27 Removed redundant pullups
    [mcu.kicad_sch, remote_shutter.kicad_sch]
2022-11-27 Further routing. Fixed I2C net connection.
    [interfaces.kicad_sch, mcu.kicad_sch, remote_shutter.kicad_pcb]
2022-11-27 Initial routing complete
    [mcu.kicad_sch, remote_shutter.kicad_pcb]
2022-11-27 Added logo. Changed RST route.
    [remote_shutter.kicad_pcb]
2022-11-27 Fixed cap placement
    C11 and C12 were placed under the battery
    [remote_shutter.kicad_pcb]
2022-11-27 Fixed jack pinout
    [remote_shutter.kicad_pcb]
2022-11-27 DRC error fixes.
    [BOM.xlsx, remote_shutter.kicad_pcb]
2022-11-27 Added initial Arduino software project
2022-12-04 Fixed via sizes. Added IO0 pullup.
    [comms.kicad_sch, interfaces.kicad_sch, power.kicad_sch, remote_shutter.kicad_pcb, remote_shutter.kicad_sch]
2022-12-04 Added controller project.
    [remote_shutter_controller.kicad_pcb, remote_shutter_controller.kicad_sch]
2022-12-05 Work on the controller
    [remote_shutter_controller.kicad_sch]
2022-12-25 Work on the controller PCB
    [BOM.xlsx, comms.kicad_sch, interfaces.kicad_sch, mcu.kicad_sch, power.kicad_sch, remote_shutter_controller.kicad_sch]
2023-01-10 Schematic updates. First export to PCB
    Added 9V line, OLED switch circuit. Added OLED footprint.
    [BOM.xlsx, comms.kicad_sch, interfaces.kicad_sch, mcu.kicad_sch, power.kicad_sch, remote_shutter_controller.kicad_pcb, remote_shutter_controller.kicad_sch]
2023-01-21 Started layout, replaced footprint for battery connector
2023-01-21 Further layout work
    [remote_shutter_controller.kicad_pcb]
2023-01-21 Layout pre-routing
    [mcu.kicad_sch, power.kicad_sch, remote_shutter_controller.kicad_pcb, remote_shutter_controller.kicad_sch]
2023-01-23 Initial routing.
    [remote_shutter_controller.kicad_pcb]
2023-04-02 Added debug connectors
    [BOM.xlsx, interfaces.kicad_sch, mcu.kicad_sch, remote_shutter.kicad_pcb, remote_shutter.kicad_sch]
2023-04-02 Updated routing, ground plane now empty
    [remote_shutter.kicad_pcb]
2023-04-02 More routing updates
    [remote_shutter.kicad_pcb]
2023-04-07 Small updates
    [remote_shutter.kicad_pcb]
2023-05-06 Changing layout & updated ESP footprint
    [remote_shutter.kicad_pcb]
2023-05-07 Changed layout for better routing. New routing.
    [remote_shutter.kicad_pcb, remote_shutter.kicad_sch]
2023-05-07 Fixed DRC issues. Updated revision number
    [remote_shutter.kicad_pcb]
